austinscreations/Rack-Fan-Controller/README.md

# Rack-Fan-Controller
a controller that can monitor temperature in rack enclosures and control fans

2023-10-25 files have been updated and all JLCPCB PCBa files have now been included.

fan controller is a 4 layer PCB

breakout is 2 layers
