austinscreations/Rack-Fan-Controller/rev 310/breakout pcb/README.md

fan breakout has been upgraded to kicad 7 format
