austinscreations/Rack-Fan-Controller/rev 310/fan controller pcb/README.md

fan controller has been upgraded to kicad 7 format
