austinscreations/Rack-Fan-Controller/port PWR extention/port PWR extention bottom.jpg

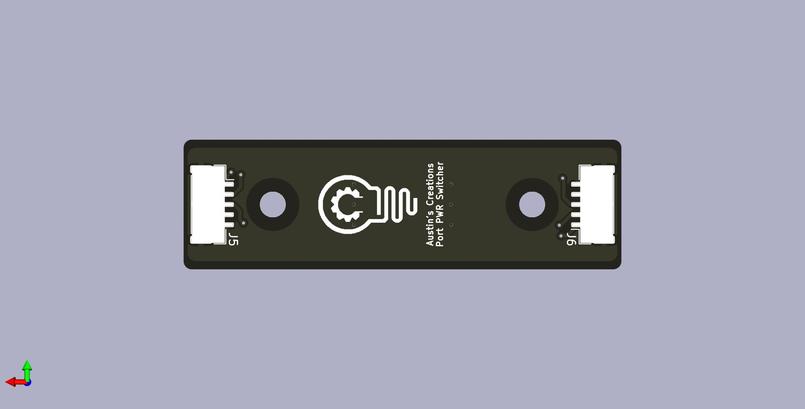
port PWR extention/port PWR extention bottom.jpg
