austinscreations/Rack-Fan-Controller/port PWR extention/port PWR extention schematic.jpg

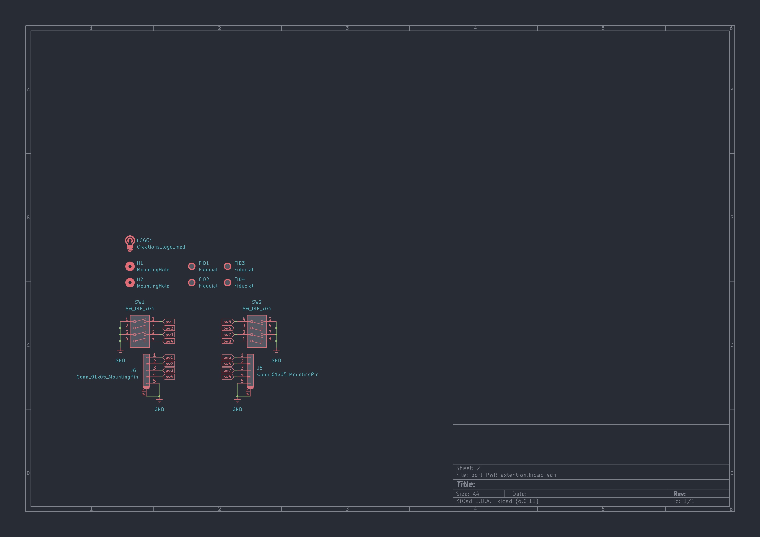
port PWR extention/port PWR extention schematic.jpg
