austinscreations/Rack-Fan-Controller/port PWR extention/port PWR extention top.jpg

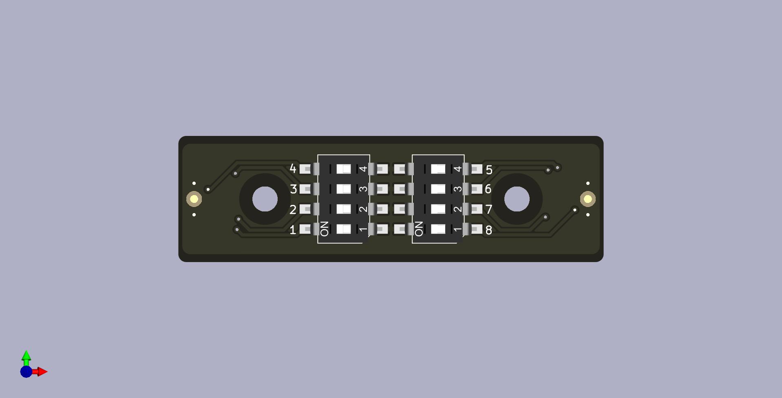
port PWR extention/port PWR extention top.jpg
