austinscreations/Rack-Fan-Controller/rev 310/breakout pcb/fan breakout bottom.jpg

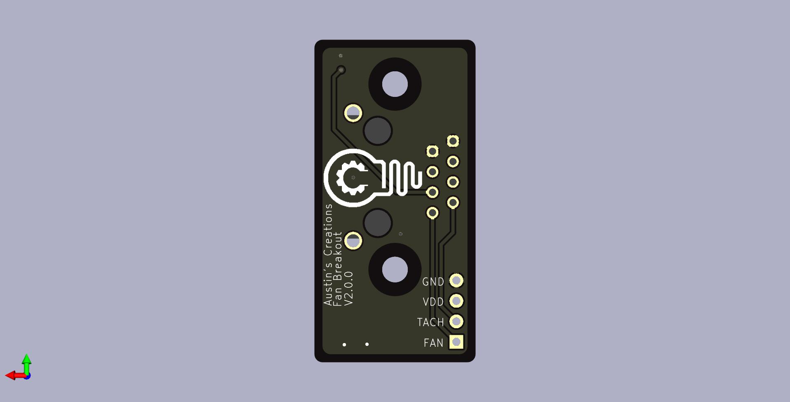
rev 310/breakout pcb/fan breakout bottom.jpg
