austinscreations/Rack-Fan-Controller/rev 310/breakout pcb/Fan breakout schematic.jpg

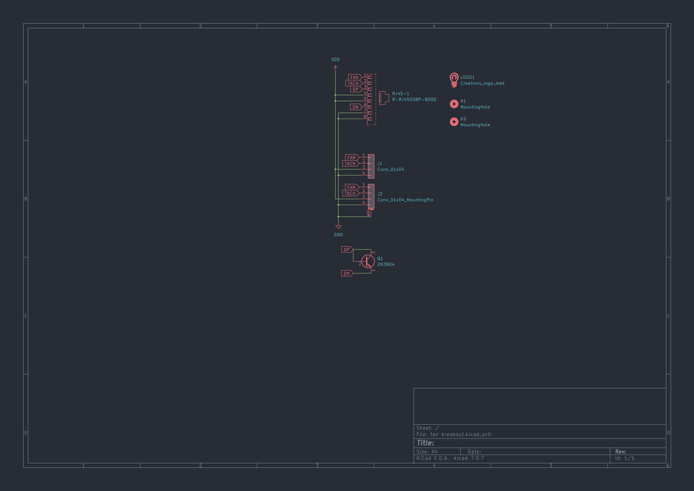
rev 310/breakout pcb/Fan breakout schematic.jpg
