austinscreations/Rack-Fan-Controller/rev 310/fan controller pcb/fan controller modular schematic.jpg

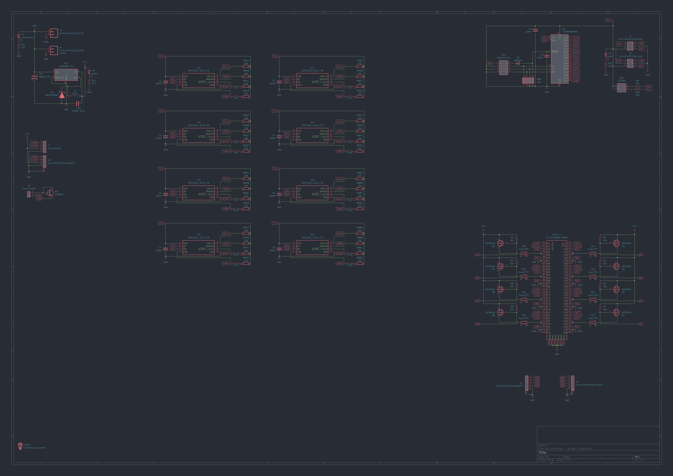
rev 310/fan controller pcb/fan controller modular schematic.jpg
