austinscreations/Rack-Fan-Controller/port PWR extention/jlcpcb/assembly/BOM-port PWR extention.csv

Comment | Designator | Footprint | LCSC
Conn_01x05_MountingPin | J5,J6 | JST_GH_SM05B-GHS-TB_1x05-1MP_P1.25mm_Horizontal | C225114
SW_DIP_x04 | SW1,SW2 | 4P_DIP | C2758183
