austinscreations/Rack-Fan-Controller/port PWR extention/port PWR extention.step

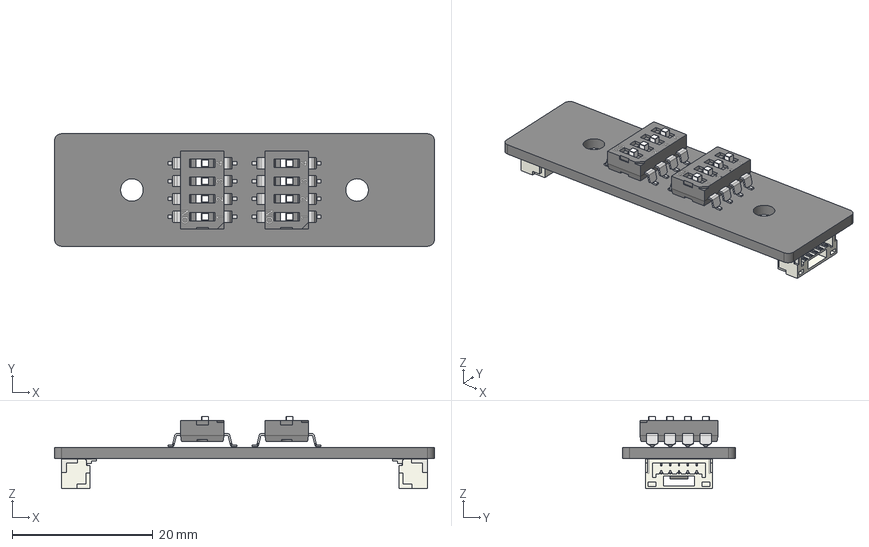
[picture p7: CAD file, 2023-10-25]
port PWR extention/port PWR extention.step
54.0 x 16.0 x 10.3 mm
_autosave-port PWR extention PCB
