austinscreations/Rack-Fan-Controller/rev 310/breakout pcb/fan breakout.step

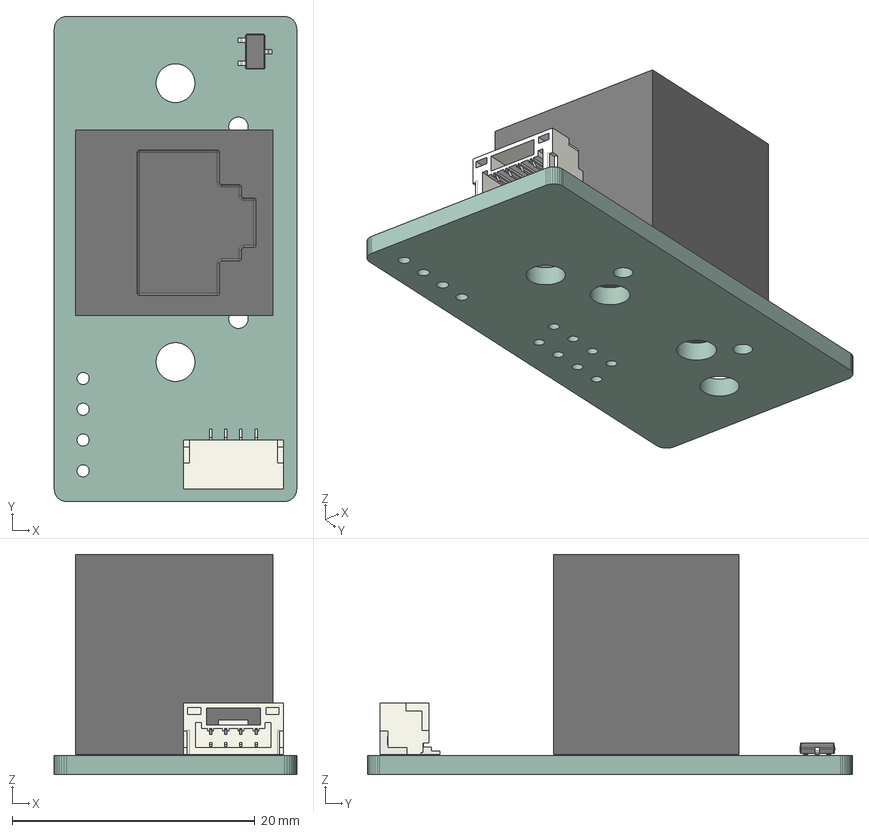
[picture p8: CAD file, 2023-10-25]
rev 310/breakout pcb/fan breakout.step
20.0 x 40.0 x 18.2 mm
fan breakout PCB
