austinscreations/Rack-Fan-Controller/port PWR extention/port PWR extention.kicad_pcb

## KiCad design port PWR extention/port PWR extention.kicad_pcb (2023-10-25)

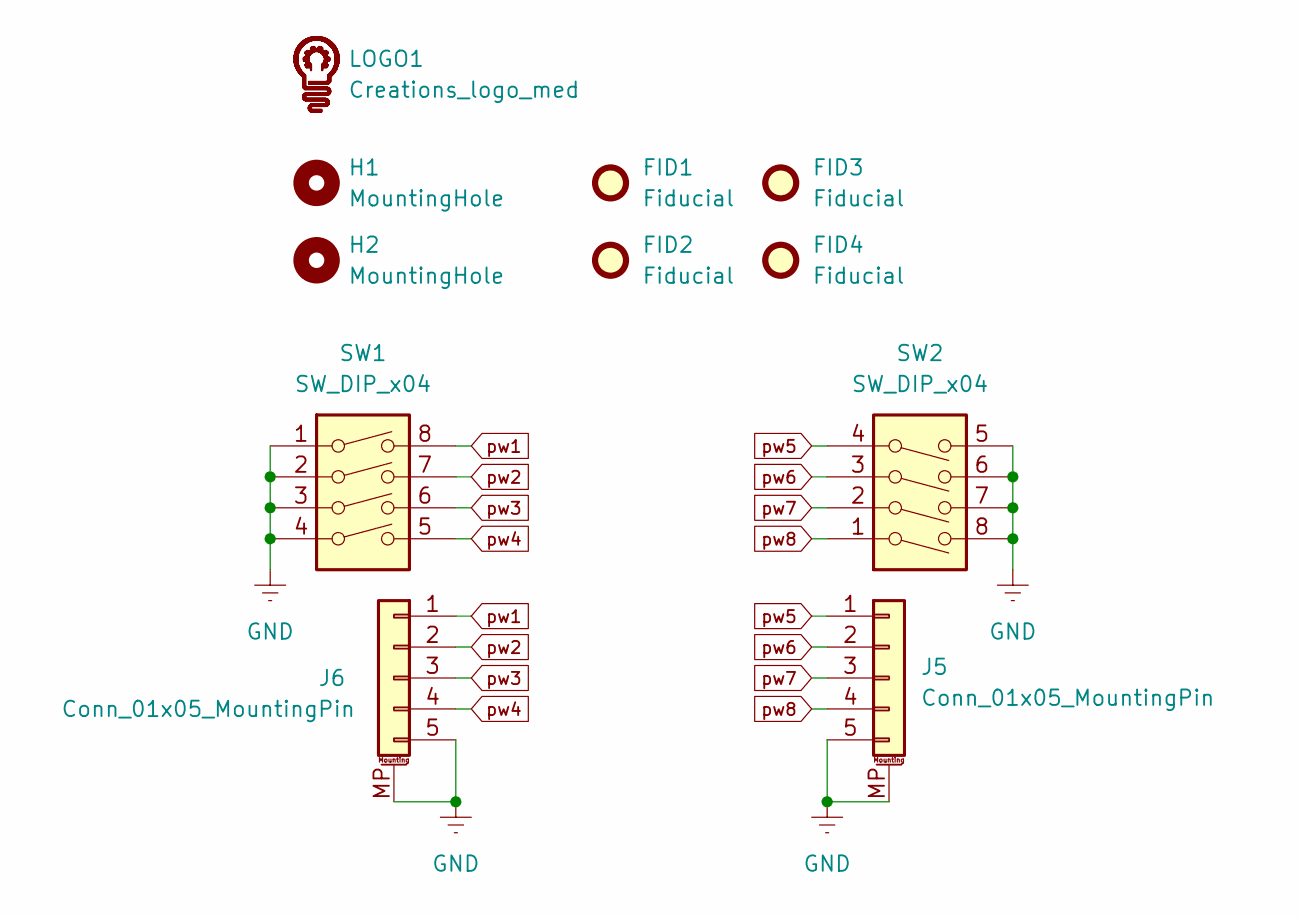
[picture p9: schematic port PWR extention.kicad_sch]

Parts:
FID1, FID2, FID3, FID4: Fiducial; Fiducial_1mm_Mask2mm
H1, H2: MountingHole; MountingHole_3.2mm_M3
J5, J6: Conn_01x05_MountingPin; JST_GH_SM05B-GHS-TB_1x05-1MP_P1.25mm_Horizontal; LCSC C225114
LOGO1: Creations_logo_med; Creations logo med
SW1, SW2: SW_DIP_x04; 4P_DIP; LCSC C2758183

Connections:
GNDREF: J5.5, J5.MP (MountPin), J6.5, J6.MP (MountPin), SW1.1, SW1.2, SW1.3, SW1.4, SW2.5, SW2.6, SW2.7, SW2.8
pw1: J6.1, SW1.8
pw2: J6.2, SW1.7
pw3: J6.3, SW1.6
pw4: J6.4, SW1.5
pw5: J5.1, SW2.4
pw6: J5.2, SW2.3
pw7: J5.3, SW2.2
pw8: J5.4, SW2.1

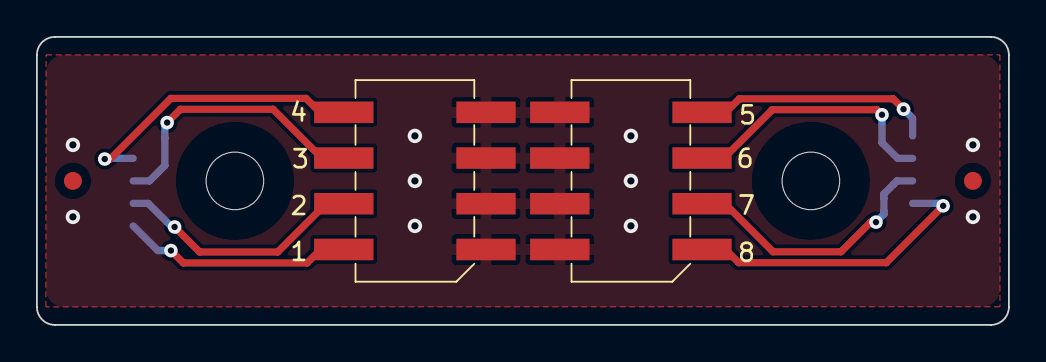
[picture p10: board port PWR extention.kicad_pcb from above]

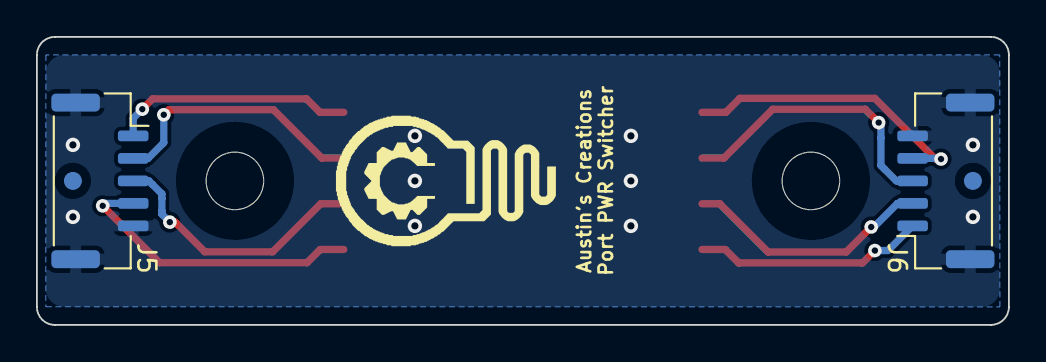
[picture p11: board port PWR extention.kicad_pcb from below]

Board: 2 copper layers, 54.0 x 16.0 mm, 11 parts (5 on the bottom side), 9 nets.
