austinscreations/Rack-Fan-Controller/rev 310/fan controller pcb/fan controller 310.kicad_pcb

## KiCad design rev 310/fan controller pcb/fan controller 310.kicad_pcb (2023-10-25)

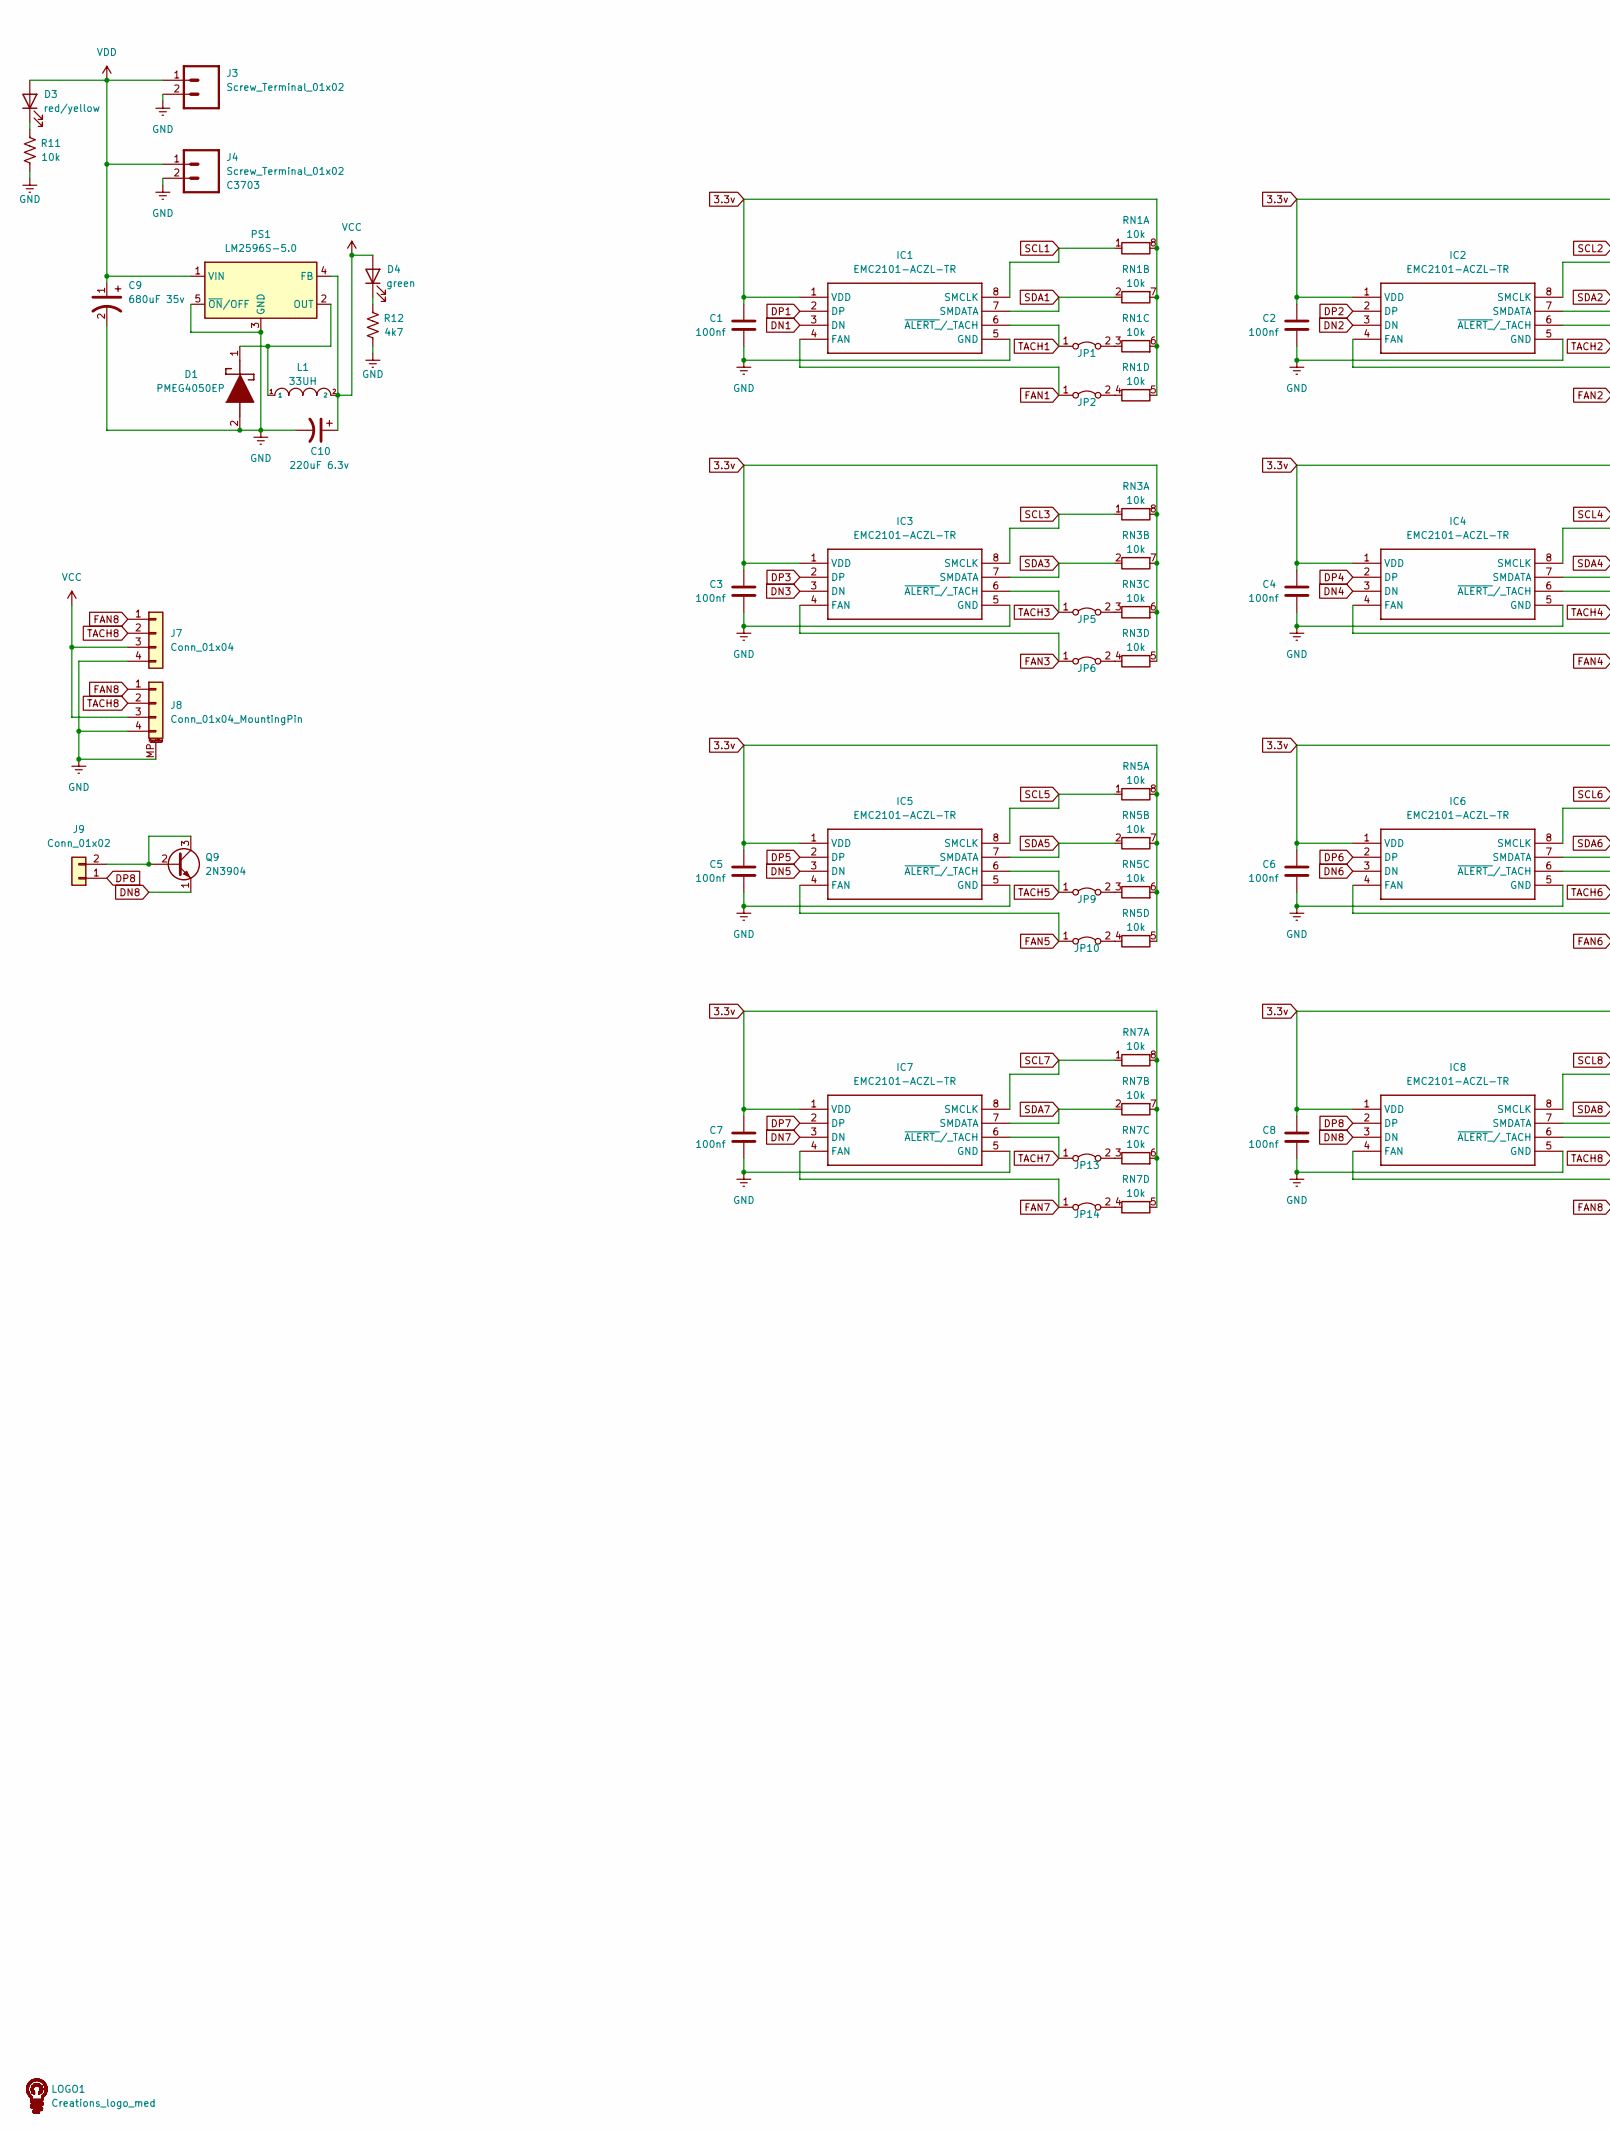
[picture p12: schematic fan controller 310.kicad_sch, part in row 1, column 1]

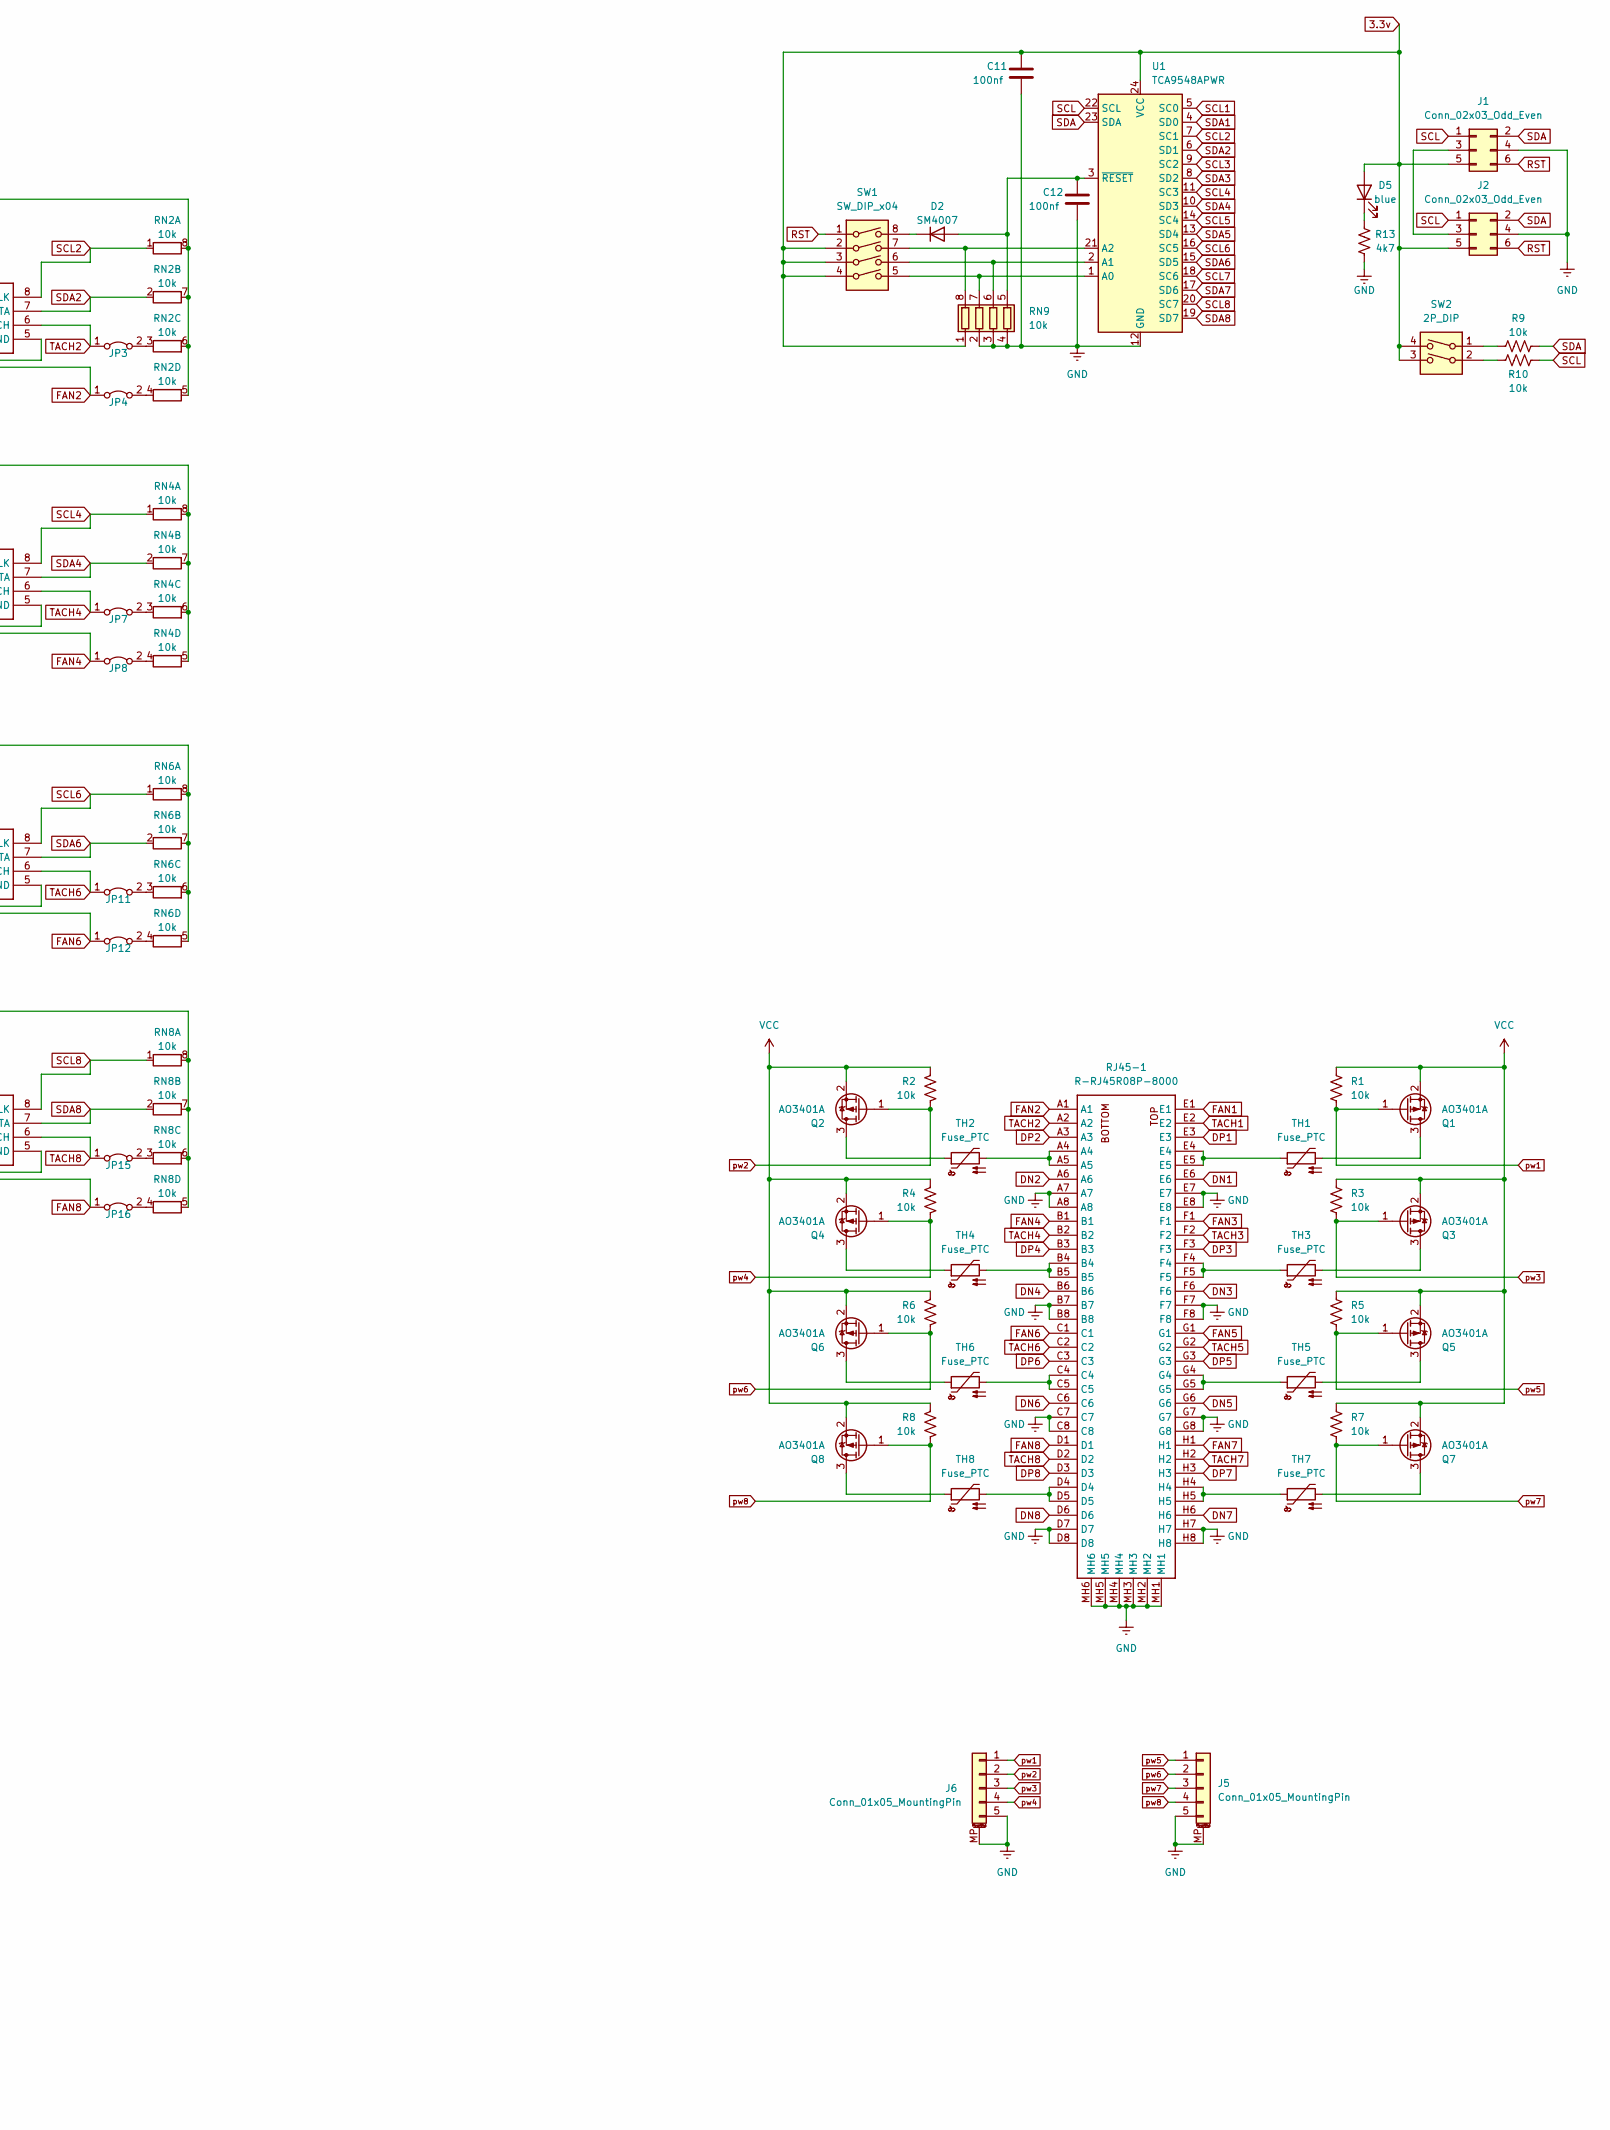
[picture p13: schematic fan controller 310.kicad_sch, part in row 1, column 2]

Parts:
C1, C2, C3, C4, C5, C6, C7, C8, C11, C12: 100nf; C_0603_1608Metric; LCSC C14663
C9: 680uF 35v; large capacitor 12.5d 13.5h; LCSC C98216
C10: 220uF 6.3v; CP_Elec_8x6.2; LCSC C401613
D1: PMEG4050EP; PMEG3050EP; LCSC C96235
D2: SM4007; D_SOD-123F; LCSC C64898
D3: red/yellow; LED_0603_1608Metric; LCSC C72038
D4: green; LED_0603_1608Metric; LCSC C72043
D5: blue; LED_0603_1608Metric; LCSC C72041
IC1, IC2, IC3, IC4, IC5, IC6, IC7, IC8: EMC2101-ACZL-TR; 8-MSOP; LCSC C626967
J1, J2: Conn_02x03_Odd_Even; IDC-Header_2x03_P2.54mm_Vertical; LCSC C132438
J3, J4: Screw_Terminal_01x02; 2pinblock; LCSC C3703
J5, J6: Conn_01x05_MountingPin; JST_GH_SM05B-GHS-TB_1x05-1MP_P1.25mm_Horizontal; LCSC C225114
J7: Conn_01x04; PinHeader_1x04_P2.54mm_Vertical
J8: Conn_01x04_MountingPin; JST_GH_SM04B-GHS-TB_1x04-1MP_P1.25mm_Horizontal; LCSC C225113
J9: Conn_01x02; PinHeader_1x02_P2.54mm_Vertical; LCSC C2829889
JP1, JP2, JP3, JP4, JP5, JP6, JP7, JP8, JP9, JP10, JP11, JP12, JP13, JP14, JP15, JP16: Jumper_2_Bridged; SolderJumper-2_P1.3mm_Bridged_RoundedPad1.0x1.5mm
L1: 33UH; 12x12x8 inductor; LCSC C9400
LOGO1: Creations_logo_med; Creations logo med
PS1: LM2596S-5.0; LM2596S; LCSC C347421
Q1, Q2, Q3, Q4, Q5, Q6, Q7, Q8: AO3401A; SOT-23; LCSC C15127
Q9: 2N3904; TSOT-23; LCSC C18536
R1, R2, R3, R4, R5, R6, R7, R8, R9, R10, R11: 10k; R_0603_1608Metric; LCSC C25804
R12, R13: 4k7; R_0603_1608Metric; LCSC C23162
RJ45-1: R-RJ45R08P-8000; LCSC C386760
RN1, RN2, RN3, RN4, RN5, RN6, RN7, RN8, RN9: 10k; R_Array_Convex_4x0603; LCSC C29718
SW1: SW_DIP_x04; 4P_DIP; LCSC C2758183
SW2: 2P_DIP; LCSC C2758181
TH1, TH2, TH3, TH4, TH5, TH6, TH7, TH8: Fuse_PTC; R_0603_1608Metric; LCSC C883087
U1: TCA9548APWR; TSSOP-24_4.4x7.8mm_P0.65mm; LCSC C130026

Connections:
3.3v: C1.1, C2.1, C3.1, C4.1, C5.1, C6.1, C7.1, C8.1, C11.1, D5.2 (A), IC1.1 (VDD), IC2.1 (VDD), IC3.1 (VDD), IC4.1 (VDD), IC5.1 (VDD), IC6.1 (VDD), IC7.1 (VDD), IC8.1 (VDD), J1.5, J2.5, RN1.5 (R4.2), RN1.6 (R3.2), RN1.7 (R2.2), RN1.8 (R1.2), RN2.5 (R4.2), RN2.6 (R3.2), RN2.7 (R2.2), RN2.8 (R1.2), RN3.5 (R4.2), RN3.6 (R3.2), RN3.7 (R2.2), RN3.8 (R1.2), RN4.5 (R4.2), RN4.6 (R3.2), RN4.7 (R2.2), RN4.8 (R1.2), RN5.5 (R4.2), RN5.6 (R3.2), RN5.7 (R2.2), RN5.8 (R1.2), RN6.5 (R4.2), RN6.6 (R3.2), RN6.7 (R2.2), RN6.8 (R1.2), RN7.5 (R4.2), RN7.6 (R3.2), RN7.7 (R2.2), RN7.8 (R1.2), RN8.5 (R4.2), RN8.6 (R3.2), RN8.7 (R2.2), RN8.8 (R1.2), RN9.1 (R1.1), SW1.2, SW1.3, SW1.4, SW2.3, SW2.4, U1.24 (VCC)
DN1: IC1.3 (DN), RJ45-1.E6
DN2: IC2.3 (DN), RJ45-1.A6
DN3: IC3.3 (DN), RJ45-1.F6
DN4: IC4.3 (DN), RJ45-1.B6
DN5: IC5.3 (DN), RJ45-1.G6
DN6: IC6.3 (DN), RJ45-1.C6
DN7: IC7.3 (DN), RJ45-1.H6
DN8: IC8.3 (DN), Q9.1 (E), RJ45-1.D6
DP1: IC1.2 (DP), RJ45-1.E3
DP2: IC2.2 (DP), RJ45-1.A3
DP3: IC3.2 (DP), RJ45-1.F3
DP4: IC4.2 (DP), RJ45-1.B3
DP5: IC5.2 (DP), RJ45-1.G3
DP6: IC6.2 (DP), RJ45-1.C3
DP7: IC7.2 (DP), RJ45-1.H3
DP8: IC8.2 (DP), J9.1, RJ45-1.D3
FAN1: IC1.4 (FAN), JP2.1 (A), RJ45-1.E1
FAN2: IC2.4 (FAN), JP4.1 (A), RJ45-1.A1
FAN3: IC3.4 (FAN), JP6.1 (A), RJ45-1.F1
FAN4: IC4.4 (FAN), JP8.1 (A), RJ45-1.B1
FAN5: IC5.4 (FAN), JP10.1 (A), RJ45-1.G1
FAN6: IC6.4 (FAN), JP12.1 (A), RJ45-1.C1
FAN7: IC7.4 (FAN), JP14.1 (A), RJ45-1.H1
FAN8: IC8.4 (FAN), J7.1, J8.1, JP16.1 (A), RJ45-1.D1
GNDREF: C1.2, C2.2, C3.2, C4.2, C5.2, C6.2, C7.2, C8.2, C9.2, C10.2, C11.2, C12.2, D1.2 (A), IC1.5 (GND), IC2.5 (GND), IC3.5 (GND), IC4.5 (GND), IC5.5 (GND), IC6.5 (GND), IC7.5 (GND), IC8.5 (GND), J1.4, J2.4, J3.2, J4.2, J5.5, J5.MP (MountPin), J6.5, J6.MP (MountPin), J7.4, J8.4, J8.MP (MountPin), PS1.3 (GND), PS1.5 (~ON/OFF), R11.2, R12.2, R13.2, RJ45-1.A7, RJ45-1.A8, RJ45-1.B7, RJ45-1.B8, RJ45-1.C7, RJ45-1.C8, RJ45-1.D7, RJ45-1.D8, RJ45-1.E7, RJ45-1.E8, RJ45-1.F7, RJ45-1.F8, RJ45-1.G7, RJ45-1.G8, RJ45-1.H7, RJ45-1.H8, RJ45-1.MH1, RJ45-1.MH2, RJ45-1.MH3, RJ45-1.MH4, RJ45-1.MH5, RJ45-1.MH6, RN9.2 (R2.1), RN9.3 (R3.1), RN9.4 (R4.1), U1.12 (GND)
unnamed: D1.1 (K), L1.1, PS1.2 (OUT)
unnamed: C12.1, D2.2 (A), RN9.5 (R4.2), U1.3 (~RESET)
unnamed: D2.1 (K), SW1.8
unnamed: D3.1 (K), R11.1
unnamed: D4.1 (K), R12.1
unnamed: D5.1 (K), R13.1
unnamed: J1.3, J2.3
unnamed: J9.2, Q9.2 (B), Q9.3 (C)
unnamed: JP1.2 (B), RN1.3 (R3.1)
unnamed: JP2.2 (B), RN1.4 (R4.1)
unnamed: JP3.2 (B), RN2.3 (R3.1)
unnamed: JP4.2 (B), RN2.4 (R4.1)
unnamed: JP5.2 (B), RN3.3 (R3.1)
unnamed: JP6.2 (B), RN3.4 (R4.1)
unnamed: JP7.2 (B), RN4.3 (R3.1)
unnamed: JP8.2 (B), RN4.4 (R4.1)
unnamed: JP9.2 (B), RN5.3 (R3.1)
unnamed: JP10.2 (B), RN5.4 (R4.1)
unnamed: JP11.2 (B), RN6.3 (R3.1)
unnamed: JP12.2 (B), RN6.4 (R4.1)
unnamed: JP13.2 (B), RN7.3 (R3.1)
unnamed: JP14.2 (B), RN7.4 (R4.1)
unnamed: JP15.2 (B), RN8.3 (R3.1)
unnamed: JP16.2 (B), RN8.4 (R4.1)
unnamed: Q1.3 (D), TH1.2
unnamed: Q2.3 (D), TH2.1
unnamed: Q3.3 (D), TH3.2
unnamed: Q4.3 (D), TH4.1
unnamed: Q5.3 (D), TH5.2
unnamed: Q6.3 (D), TH6.1
unnamed: Q7.3 (D), TH7.2
unnamed: Q8.3 (D), TH8.1
unnamed: R9.1, SW2.1
unnamed: R10.1, SW2.2
unnamed: RJ45-1.A4, RJ45-1.A5, TH2.2
unnamed: RJ45-1.B4, RJ45-1.B5, TH4.2
unnamed: RJ45-1.C4, RJ45-1.C5, TH6.2
unnamed: RJ45-1.D4, RJ45-1.D5, TH8.2
unnamed: RJ45-1.E4, RJ45-1.E5, TH1.1
unnamed: RJ45-1.F4, RJ45-1.F5, TH3.1
unnamed: RJ45-1.G4, RJ45-1.G5, TH5.1
unnamed: RJ45-1.H4, RJ45-1.H5, TH7.1
unnamed: RN9.8 (R1.2), SW1.7, U1.21 (A2)
unnamed: RN9.7 (R2.2), SW1.5, U1.1 (A0)
unnamed: RN9.6 (R3.2), SW1.6, U1.2 (A1)
RST: J1.6, J2.6, SW1.1
SCL: J1.1, J2.1, R10.2, U1.22 (SCL)
SCL1: IC1.8 (SMCLK), RN1.1 (R1.1), U1.5 (SC0)
SCL2: IC2.8 (SMCLK), RN2.1 (R1.1), U1.7 (SC1)
SCL3: IC3.8 (SMCLK), RN3.1 (R1.1), U1.9 (SC2)
SCL4: IC4.8 (SMCLK), RN4.1 (R1.1), U1.11 (SC3)
SCL5: IC5.8 (SMCLK), RN5.1 (R1.1), U1.14 (SC4)
SCL6: IC6.8 (SMCLK), RN6.1 (R1.1), U1.16 (SC5)
SCL7: IC7.8 (SMCLK), RN7.1 (R1.1), U1.18 (SC6)
SCL8: IC8.8 (SMCLK), RN8.1 (R1.1), U1.20 (SC7)
SDA: J1.2, J2.2, R9.2, U1.23 (SDA)
SDA1: IC1.7 (SMDATA), RN1.2 (R2.1), U1.4 (SD0)
SDA2: IC2.7 (SMDATA), RN2.2 (R2.1), U1.6 (SD1)
SDA3: IC3.7 (SMDATA), RN3.2 (R2.1), U1.8 (SD2)
SDA4: IC4.7 (SMDATA), RN4.2 (R2.1), U1.10 (SD3)
SDA5: IC5.7 (SMDATA), RN5.2 (R2.1), U1.13 (SD4)
SDA6: IC6.7 (SMDATA), RN6.2 (R2.1), U1.15 (SD5)
SDA7: IC7.7 (SMDATA), RN7.2 (R2.1), U1.17 (SD6)
SDA8: IC8.7 (SMDATA), RN8.2 (R2.1), U1.19 (SD7)
TACH1: IC1.6 (~ALERT_/_TACH), JP1.1 (A), RJ45-1.E2
TACH2: IC2.6 (~ALERT_/_TACH), JP3.1 (A), RJ45-1.A2
TACH3: IC3.6 (~ALERT_/_TACH), JP5.1 (A), RJ45-1.F2
TACH4: IC4.6 (~ALERT_/_TACH), JP7.1 (A), RJ45-1.B2
TACH5: IC5.6 (~ALERT_/_TACH), JP9.1 (A), RJ45-1.G2
TACH6: IC6.6 (~ALERT_/_TACH), JP11.1 (A), RJ45-1.C2
TACH7: IC7.6 (~ALERT_/_TACH), JP13.1 (A), RJ45-1.H2
TACH8: IC8.6 (~ALERT_/_TACH), J7.2, J8.2, JP15.1 (A), RJ45-1.D2
VCC: C10.1, D4.2 (A), J7.3, J8.3, L1.2, PS1.4 (FB), Q1.2 (S), Q2.2 (S), Q3.2 (S), Q4.2 (S), Q5.2 (S), Q6.2 (S), Q7.2 (S), Q8.2 (S), R1.1, R2.2, R3.1, R4.2, R5.1, R6.2, R7.1, R8.2
VDD: C9.1, D3.2 (A), J3.1, J4.1, PS1.1 (VIN)
pw1: J6.1, Q1.1 (G), R1.2
pw2: J6.2, Q2.1 (G), R2.1
pw3: J6.3, Q3.1 (G), R3.2
pw4: J6.4, Q4.1 (G), R4.1
pw5: J5.1, Q5.1 (G), R5.2
pw6: J5.2, Q6.1 (G), R6.1
pw7: J5.3, Q7.1 (G), R7.2
pw8: J5.4, Q8.1 (G), R8.1

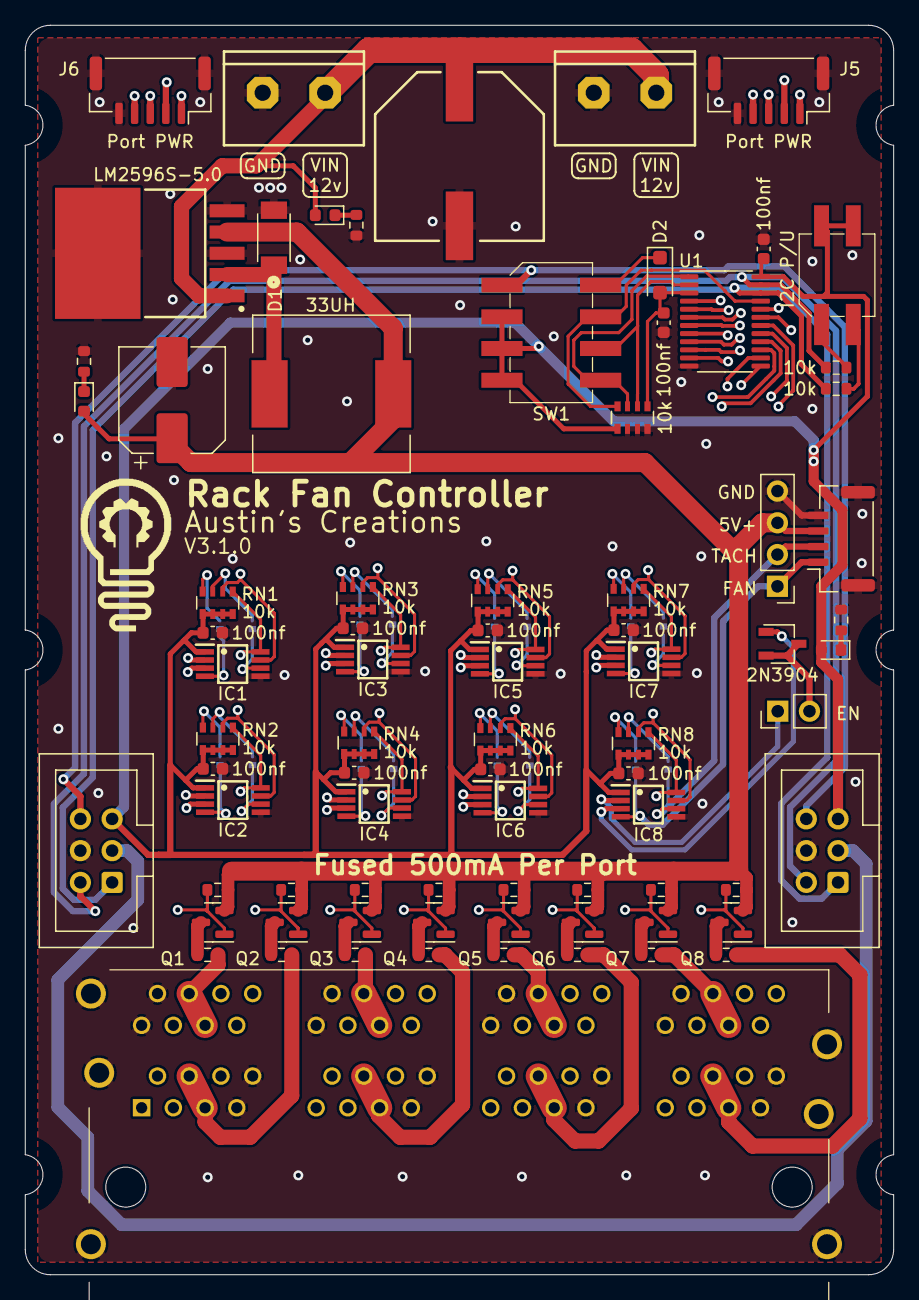
[picture p14: board fan controller 310.kicad_pcb from above]

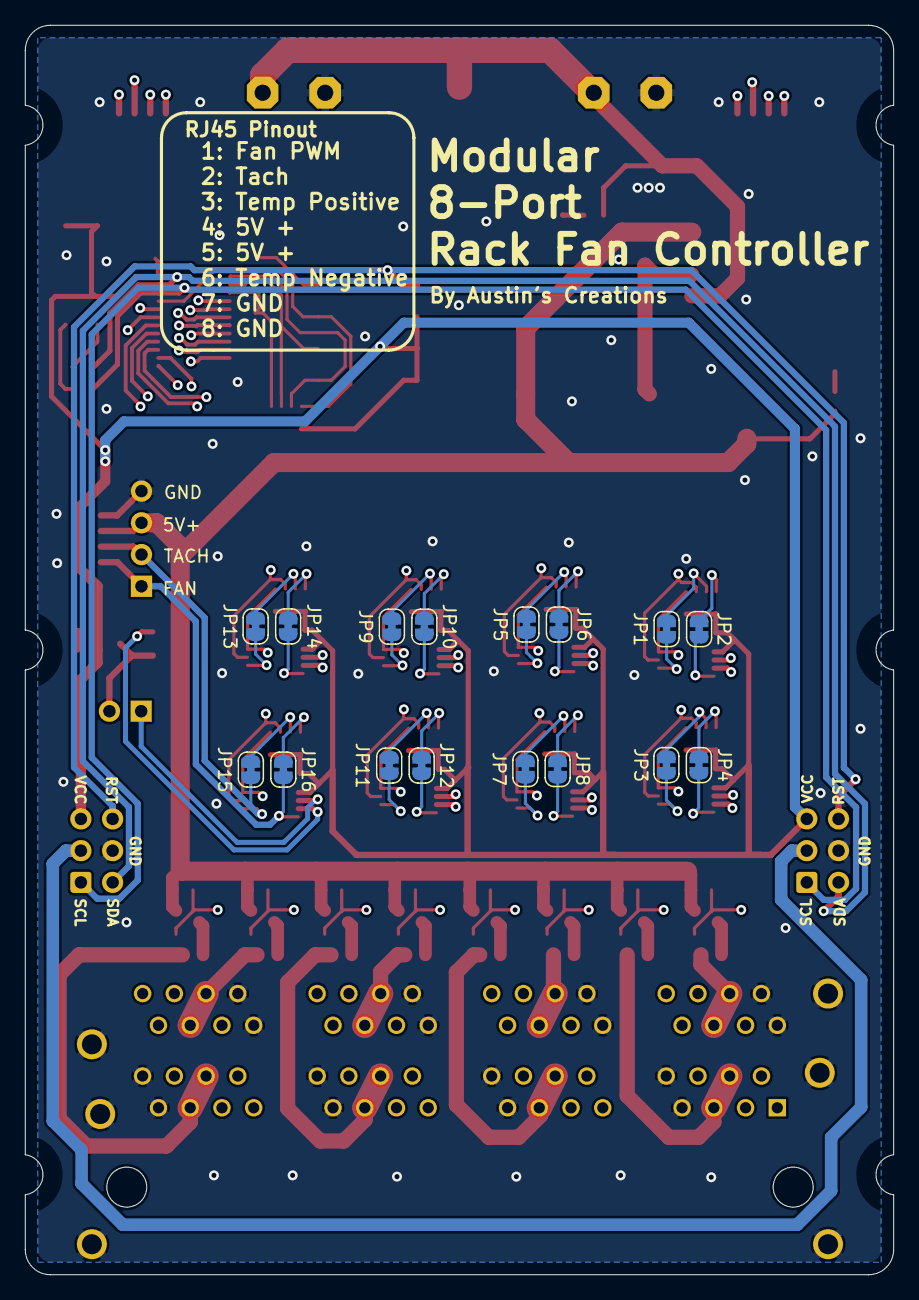
[picture p15: board fan controller 310.kicad_pcb from below]

Board: 4 copper layers, 69.5 x 100.0 mm, 96 parts (16 on the bottom side), 108 nets.
