austinscreations/Rack-Fan-Controller/rev 310/breakout pcb/fan breakout.kicad_pcb

## KiCad design rev 310/breakout pcb/fan breakout.kicad_pcb (2023-10-25)

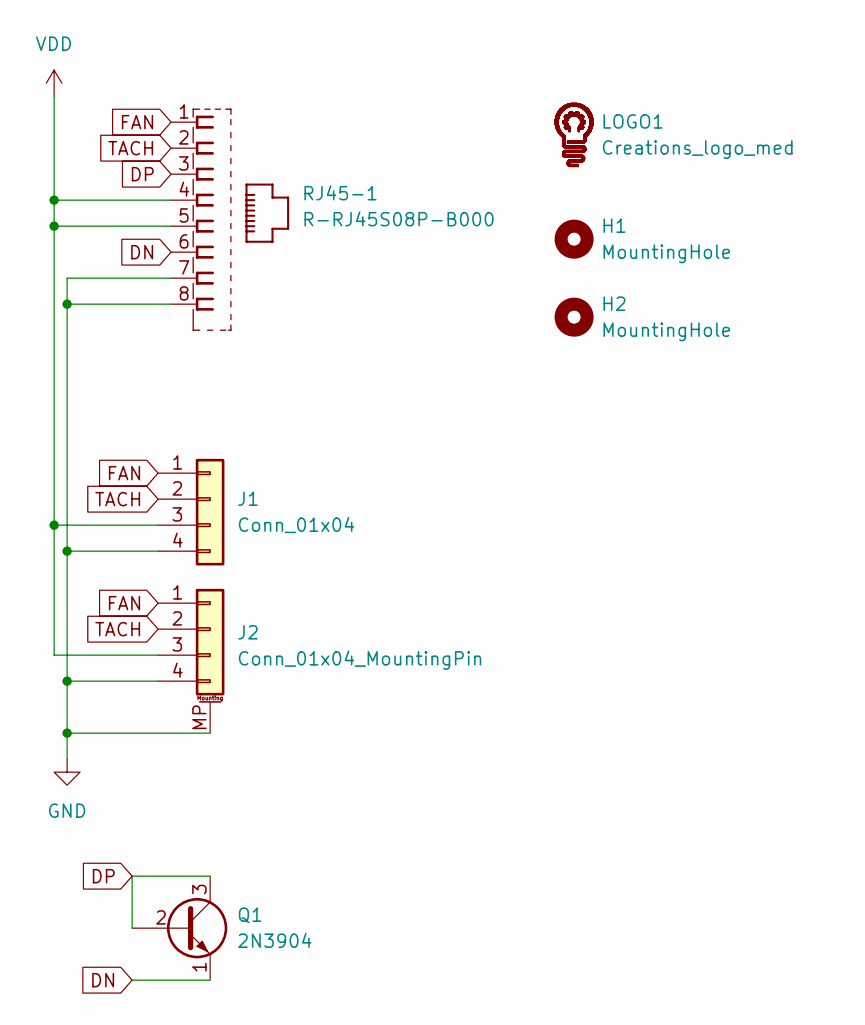
[picture p16: schematic fan breakout.kicad_sch]

Parts:
H1, H2: MountingHole; MountingHole_3.2mm_M3
J1: Conn_01x04; PinHeader_1x04_P2.54mm_Vertical
J2: Conn_01x04_MountingPin; JST_GH_SM04B-GHS-TB_1x04-1MP_P1.25mm_Horizontal; LCSC C225113
LOGO1: Creations_logo_med; Creations logo med
Q1: 2N3904; TSOT-23; LCSC C18536
RJ45-1: R-RJ45S08P-B000; LCSC C386763

Connections:
DN: Q1.1 (E), RJ45-1.6
DP: Q1.2 (B), Q1.3 (C), RJ45-1.3
FAN: J1.1, J2.1, RJ45-1.1
GND: J1.4, J2.4, J2.MP (MountPin), RJ45-1.7, RJ45-1.8
TACH: J1.2, J2.2, RJ45-1.2
VDD: J1.3, J2.3, RJ45-1.4, RJ45-1.5

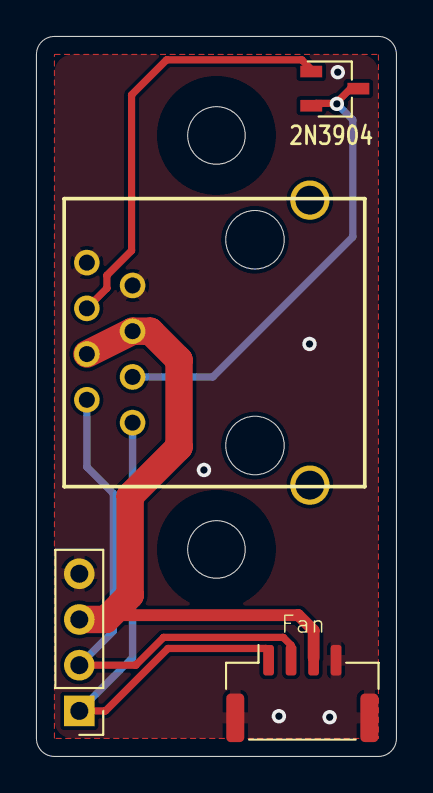
[picture p17: board fan breakout.kicad_pcb from above]

Board: 2 copper layers, 20.0 x 40.0 mm, 7 parts (1 on the bottom side), 6 nets.
